saadurrehman007/Automated-Bit-Changing-Mechanism/README.md

# Automated-Bit-Changing-Mechanism
Design of an automatic on-the-go bit-changing mechanism for robotic screwdrivers
