saadurrehman007/Automated-Bit-Changing-Mechanism/ChainDriveAss.SLDASM

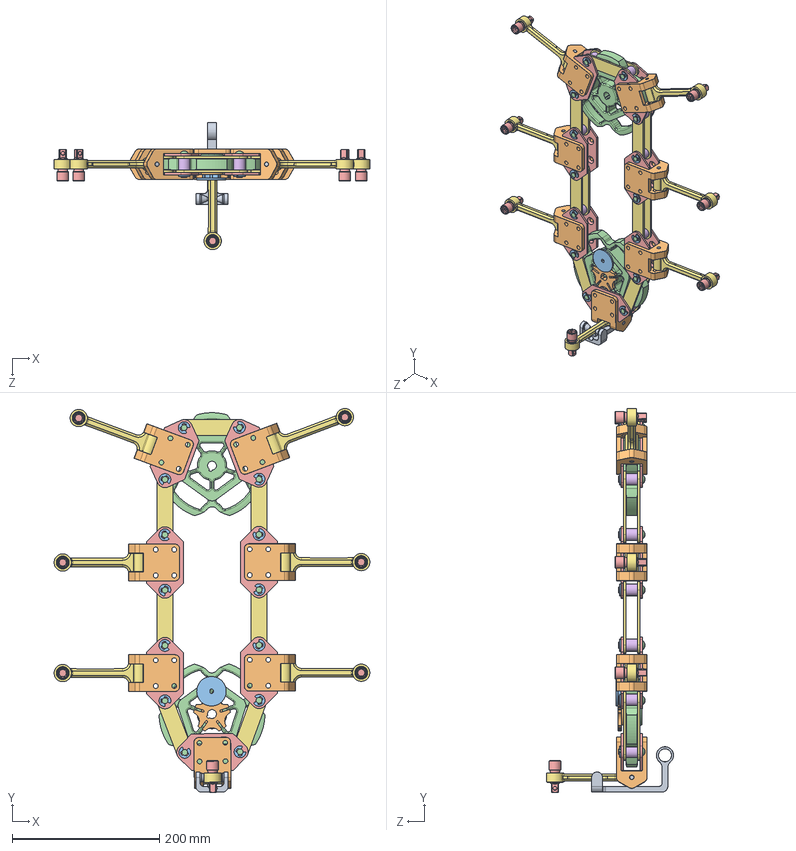
[picture p29: CAD file, 2024-09-28]
ChainDriveAss.SLDASM
428.2 x 520.8 x 172.5 mm
Link x 14
Roller x 14
AttachmentLink x 14
Pin x 14
EStyleRetainingRing x 14
Attachment x 7
DowelPin x 7
Bushing x 7
ToolArm x 7
NeedleRollerBearings x 7
SquareSocketExtension0.375 x 7
Sprocket1 x 2
GenevaDriveWheel
GenevaWheel
SwingArm
