saadurrehman007/Automated-Bit-Changing-Mechanism/ChainDriveAssemblyTree.SLDASM

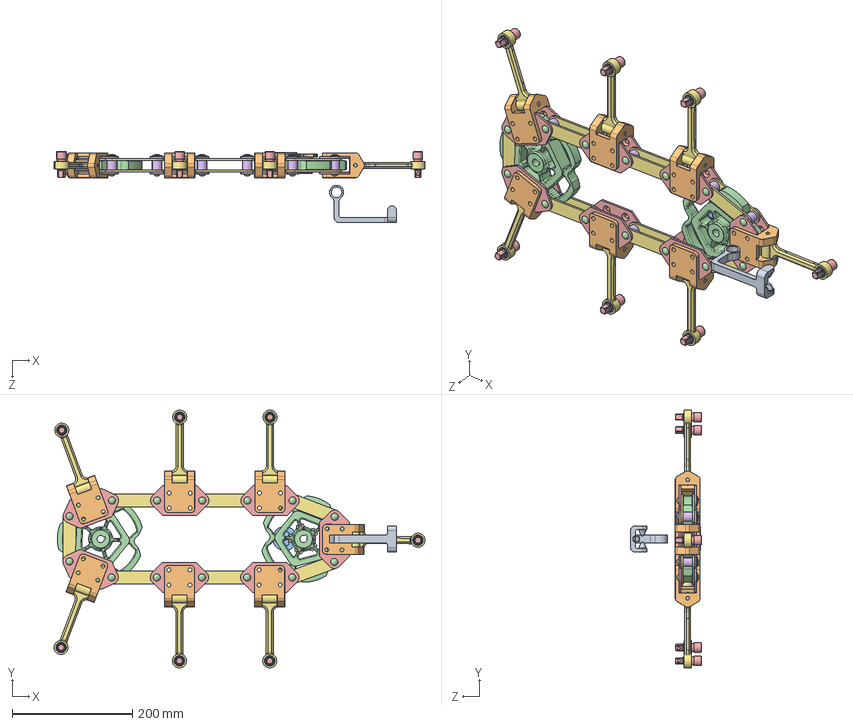
[picture p30: CAD file, 2024-09-28]
ChainDriveAssemblyTree.SLDASM
616.3 x 428.2 x 117.8 mm
Link x 14
Roller x 14
AttachmentLink x 14
Pin x 14
EStyleRetainingRing x 14
Attachment x 7
DowelPin x 7
Bushing x 7
ToolArm x 7
NeedleRollerBearings x 7
SquareSocketExtension0.375 x 7
Sprocket1 x 2
GenevaDriveWheel
GenevaWheel
SwingArm
