saadurrehman007/Automated-Bit-Changing-Mechanism/ChainGroup1.SLDASM

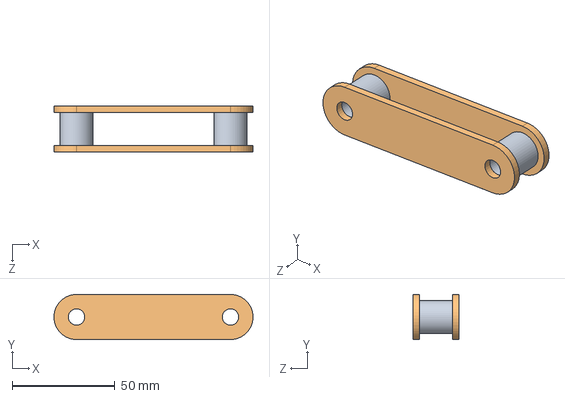
[picture p31: CAD file, 2024-09-28]
ChainGroup1.SLDASM
96.9 x 22.0 x 22.4 mm
Link x 2
Roller x 2
