saadurrehman007/Automated-Bit-Changing-Mechanism/MotionStudy.SLDASM

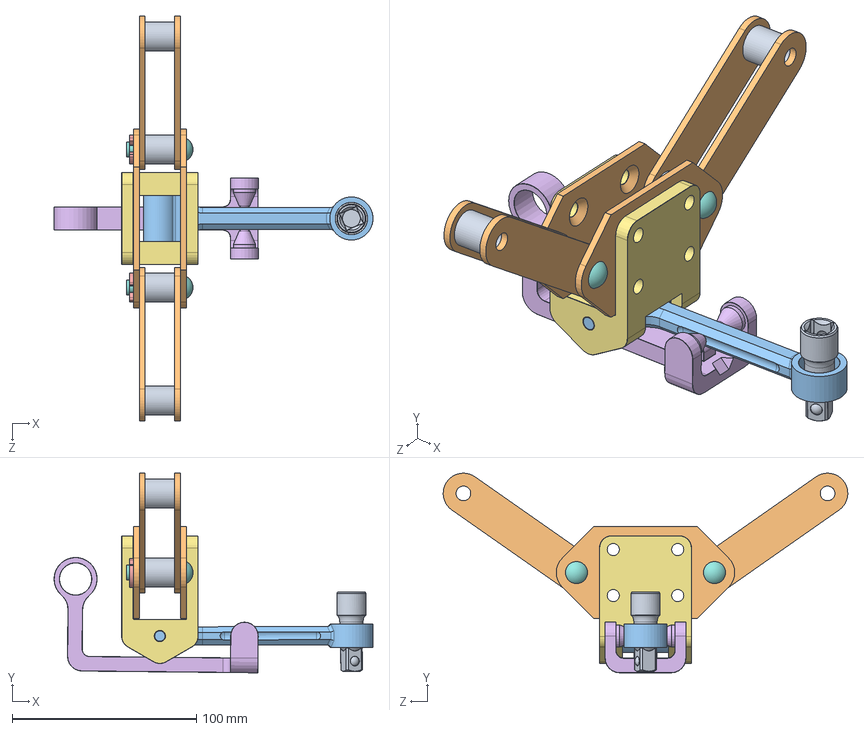
[picture p32: CAD file, 2024-09-28]
MotionStudy.SLDASM
173.3 x 108.5 x 219.8 mm
ToolArm
AttachmentLink x 2
SquareSocketExtension0.375
Pin x 2
Attachment
SwingArm
EStyleRetainingRing x 2
Bushing
DowelPin
Link x 4
Roller x 4
