saadurrehman007/Automated-Bit-Changing-Mechanism/SprocketsandGenevaMechanism.SLDASM

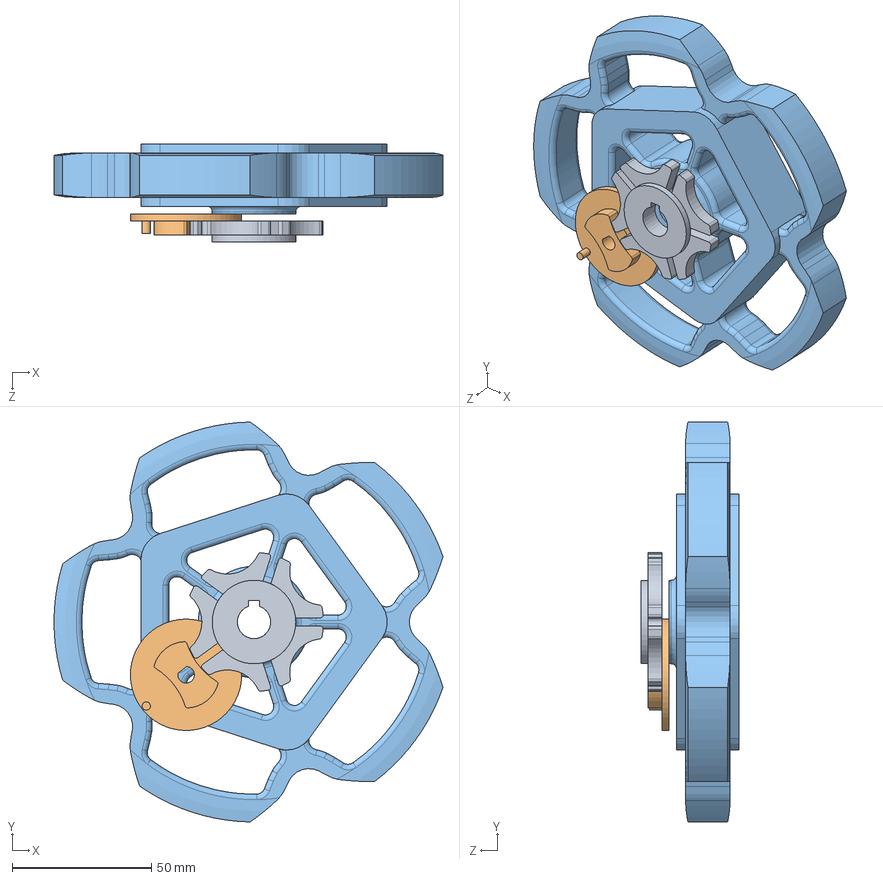
[picture p33: CAD file, 2024-09-28]
SprocketsandGenevaMechanism.SLDASM
139.7 x 143.6 x 35.2 mm
Sprocket1
GenevaDriveWheel
GenevaWheel
