saadurrehman007/Automated-Bit-Changing-Mechanism/ChainGroup2.SLDASM

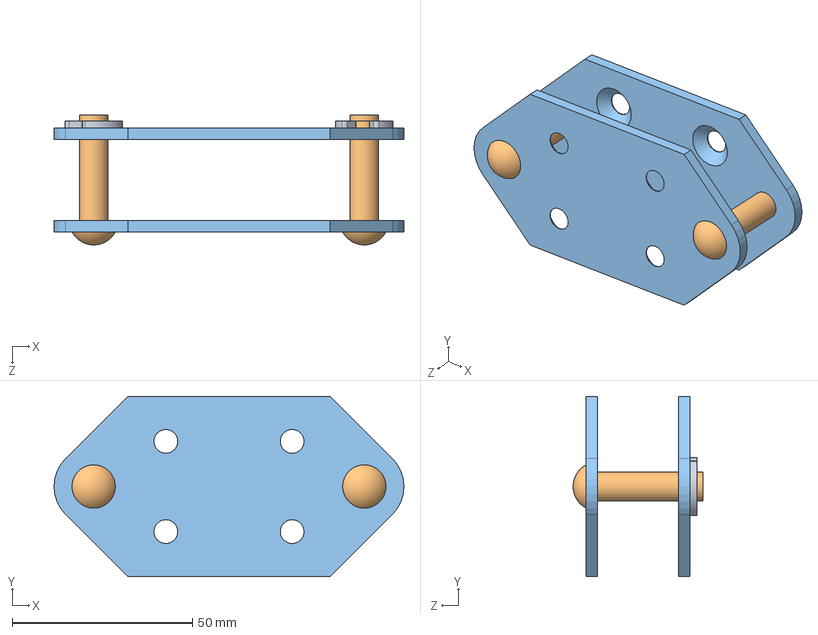
[picture p34: CAD file, 2024-09-28]
ChainGroup2.SLDASM
97.0 x 50.0 x 36.0 mm
AttachmentLink x 2
Pin x 2
EStyleRetainingRing x 2
