saadurrehman007/Automated-Bit-Changing-Mechanism/GenevaWheelMechanism.SLDASM

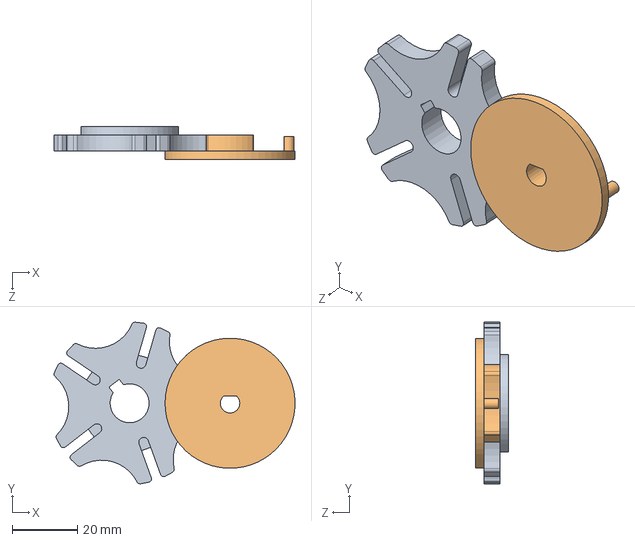
[picture p35: CAD file, 2024-09-28]
GenevaWheelMechanism.SLDASM
74.1 x 49.7 x 10.0 mm
GenevaDriveWheel
GenevaWheel
