saadurrehman007/Automated-Bit-Changing-Mechanism/AttachmentAssembly.SLDASM

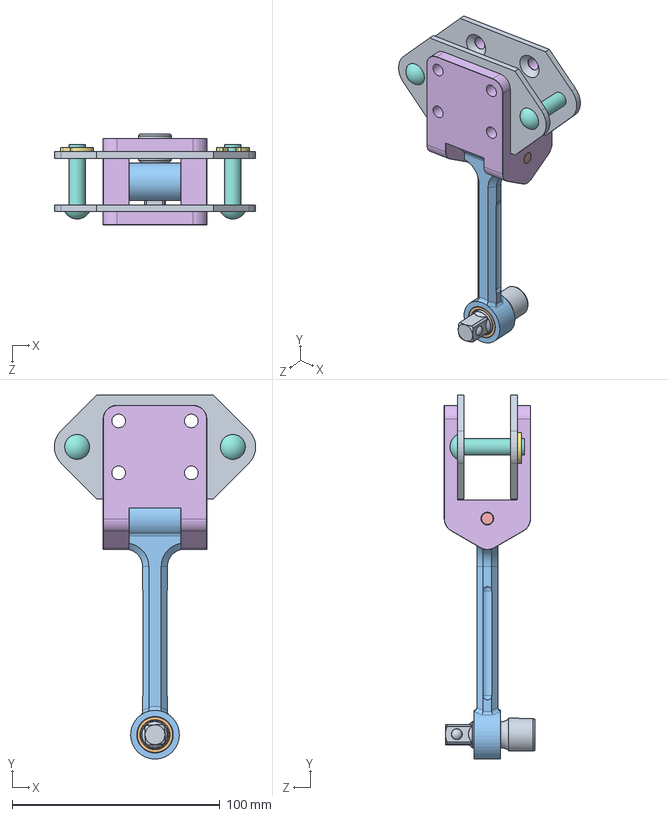
[picture p36: CAD file, 2024-09-28]
AttachmentAssembly.SLDASM
97.0 x 175.3 x 43.6 mm
AttachmentLink x 2
Pin x 2
EStyleRetainingRing x 2
Attachment
DowelPin
Bushing
ToolArm
NeedleRollerBearings
SquareSocketExtension0.375
