saadurrehman007/Automated-Bit-Changing-Mechanism/SquarePlug.SLDPRT

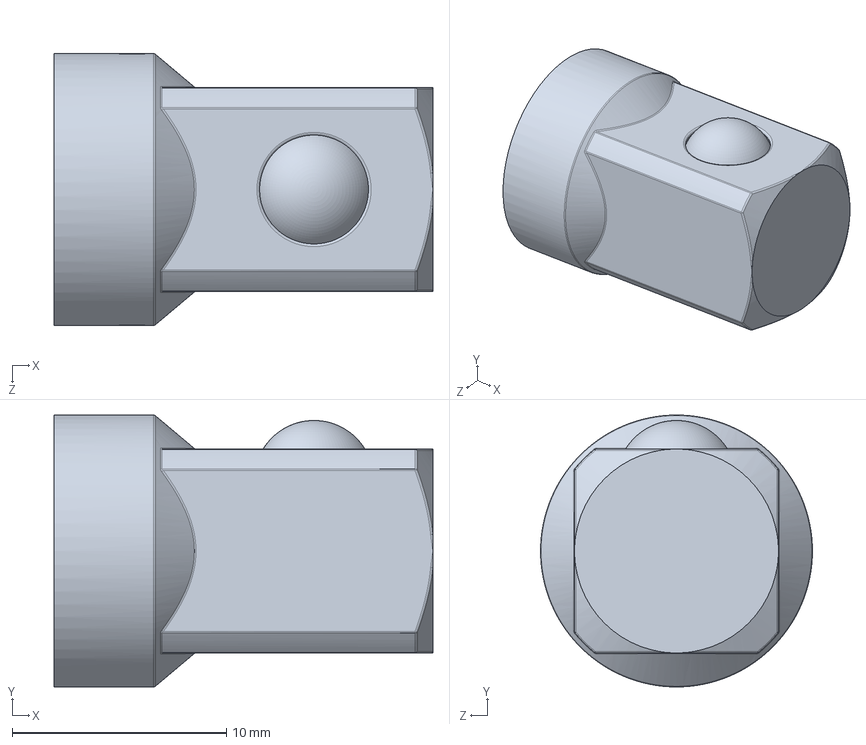
[picture p37: CAD file, 2024-09-28]
SquarePlug.SLDPRT
17.7 x 12.7 x 12.7 mm
