saadurrehman007/Automated-Bit-Changing-Mechanism/SquareSocketExtension0.375.SLDPRT

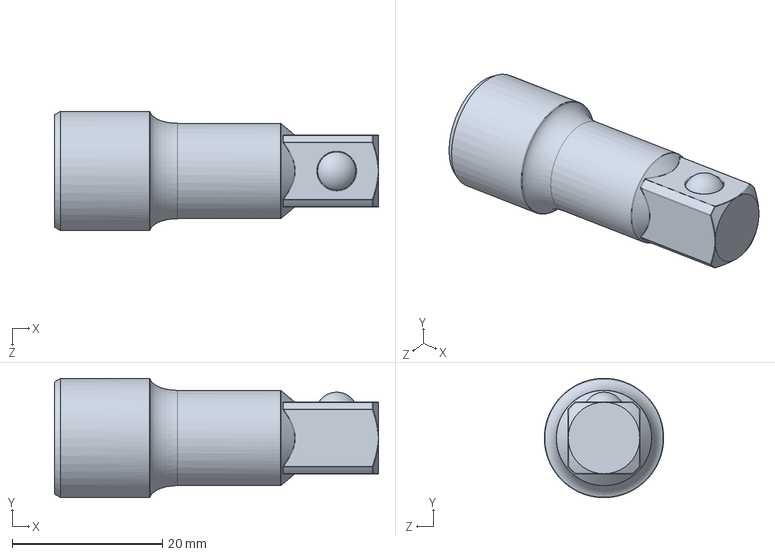
[picture p38: CAD file, 2024-09-28]
SquareSocketExtension0.375.SLDPRT
43.1 x 15.9 x 15.9 mm
