saadurrehman007/Automated-Bit-Changing-Mechanism/AttachmentLink.SLDPRT

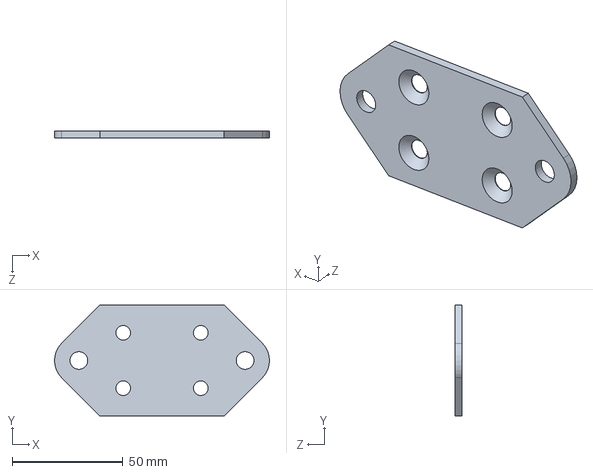
[picture p39: CAD file, 2024-09-28]
AttachmentLink.SLDPRT
97.0 x 50.0 x 3.20 mm
