saadurrehman007/Automated-Bit-Changing-Mechanism/Roller.SLDPRT

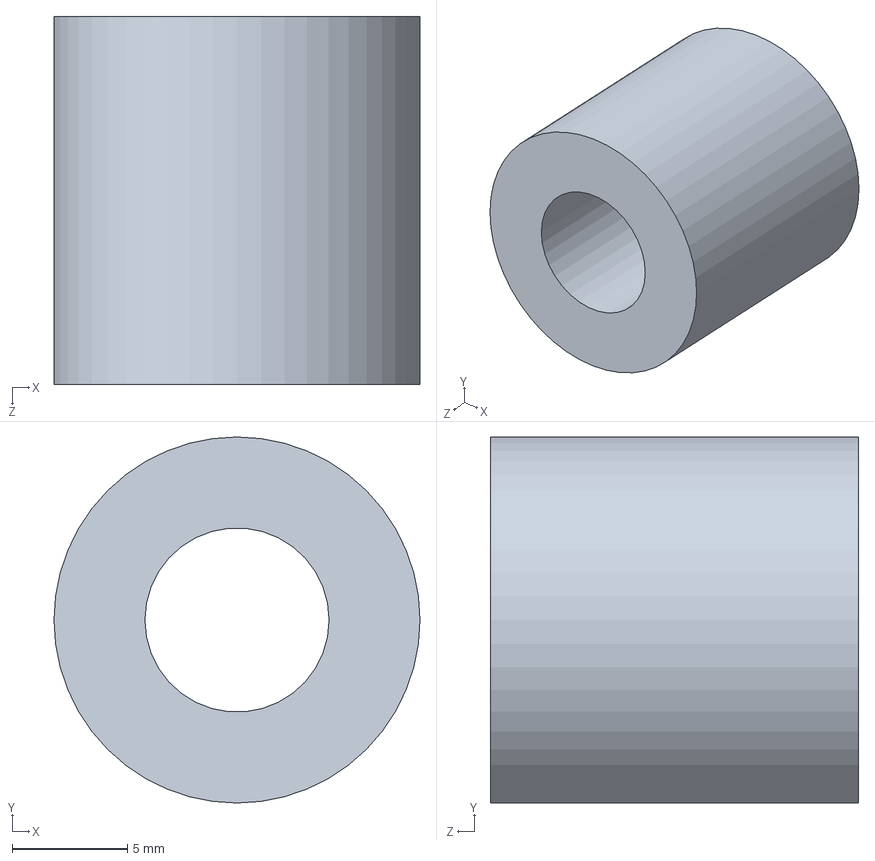
[picture p40: CAD file, 2024-09-28]
Roller.SLDPRT
15.9 x 15.9 x 16.0 mm
