saadurrehman007/Automated-Bit-Changing-Mechanism/DowelPin.SLDPRT

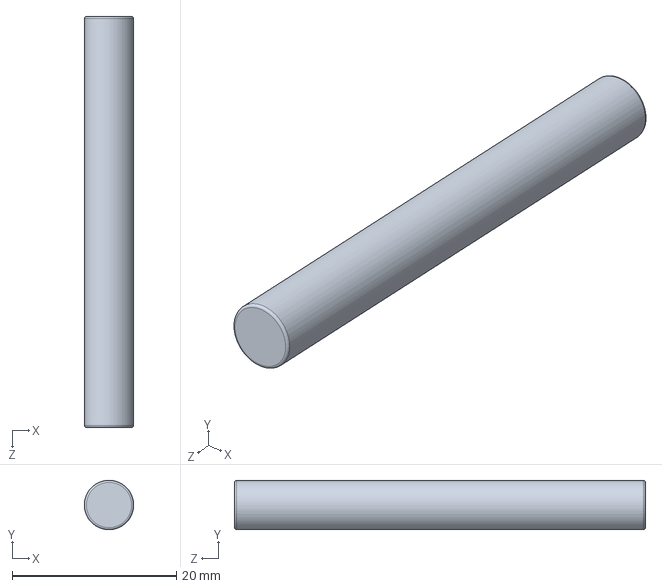
[picture p41: CAD file, 2024-09-28]
DowelPin.SLDPRT
6.00 x 6.00 x 50.0 mm
