saadurrehman007/Automated-Bit-Changing-Mechanism/Sprocket1.SLDPRT

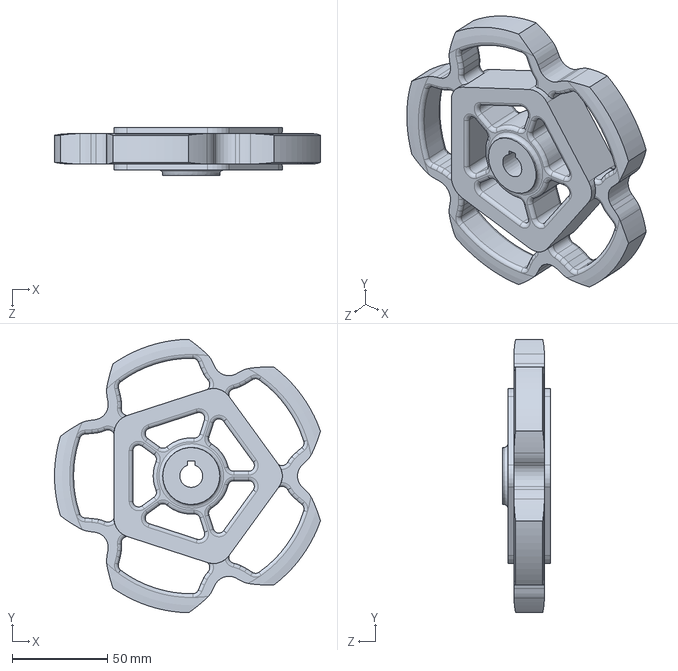
[picture p42: CAD file, 2024-09-28]
Sprocket1.SLDPRT
139.7 x 143.6 x 25.2 mm
