saadurrehman007/Automated-Bit-Changing-Mechanism/NeedleRollerBearings.SLDPRT

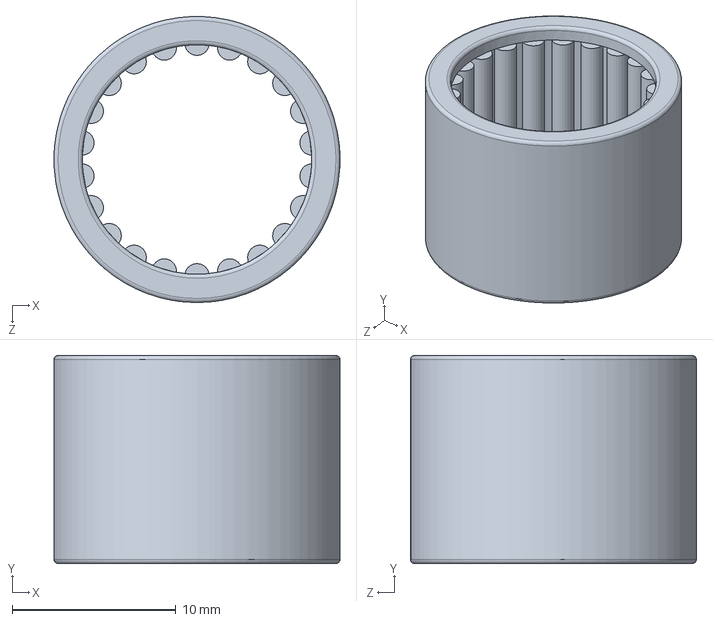
[picture p43: CAD file, 2024-09-28]
NeedleRollerBearings.SLDPRT
17.5 x 12.7 x 17.5 mm
