saadurrehman007/Automated-Bit-Changing-Mechanism/ToolArm.SLDPRT

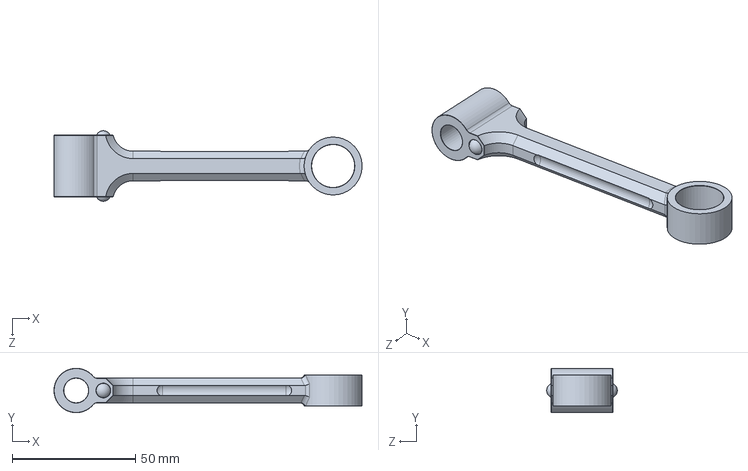
[picture p44: CAD file, 2024-09-28]
ToolArm.SLDPRT
124.8 x 18.0 x 28.6 mm
