saadurrehman007/Automated-Bit-Changing-Mechanism/Pin.SLDPRT

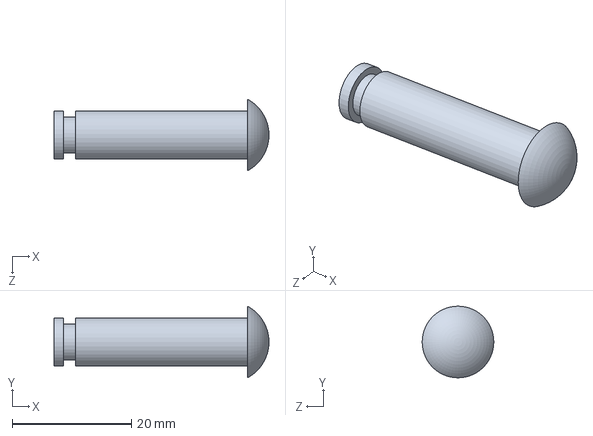
[picture p45: CAD file, 2024-09-28]
Pin.SLDPRT
36.0 x 12.0 x 12.0 mm
