saadurrehman007/Automated-Bit-Changing-Mechanism/Link.SLDPRT

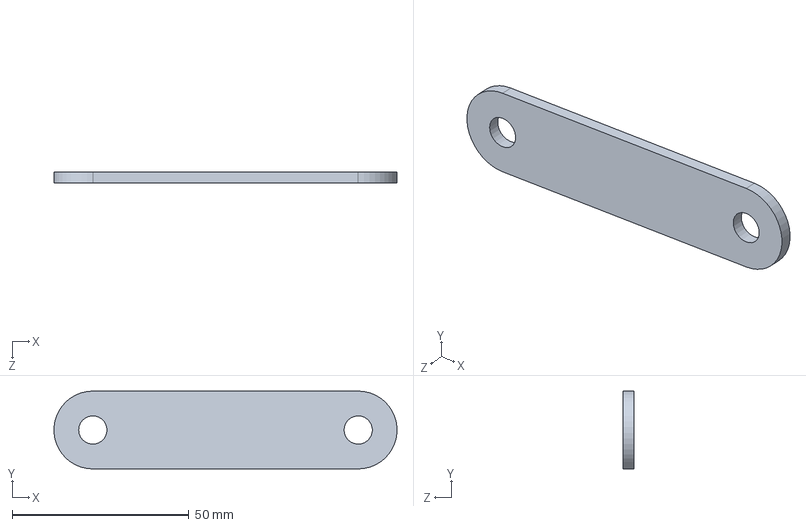
[picture p46: CAD file, 2024-09-28]
Link.SLDPRT
96.9 x 22.0 x 3.20 mm
