saadurrehman007/Automated-Bit-Changing-Mechanism/Bushing.SLDPRT

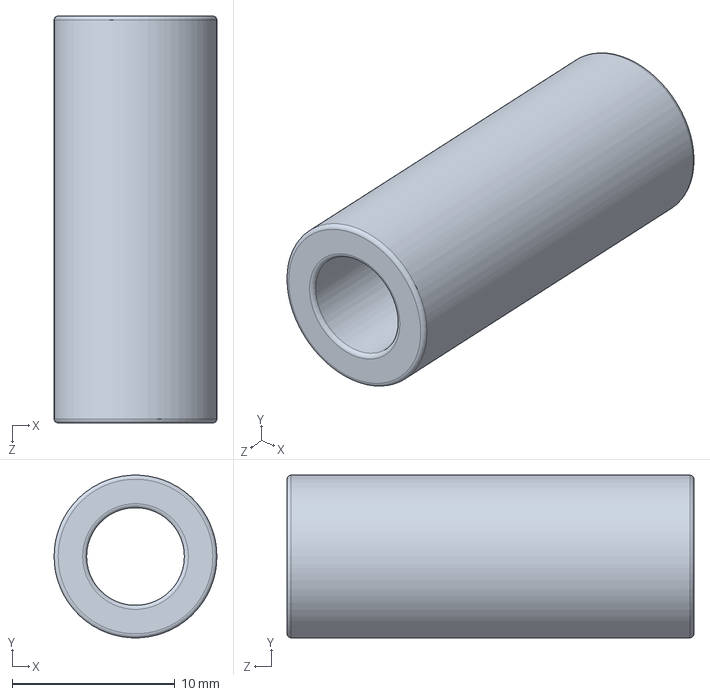
[picture p47: CAD file, 2024-09-28]
Bushing.SLDPRT
10.0 x 10.0 x 25.0 mm
