saadurrehman007/Automated-Bit-Changing-Mechanism/SwingArm.SLDPRT

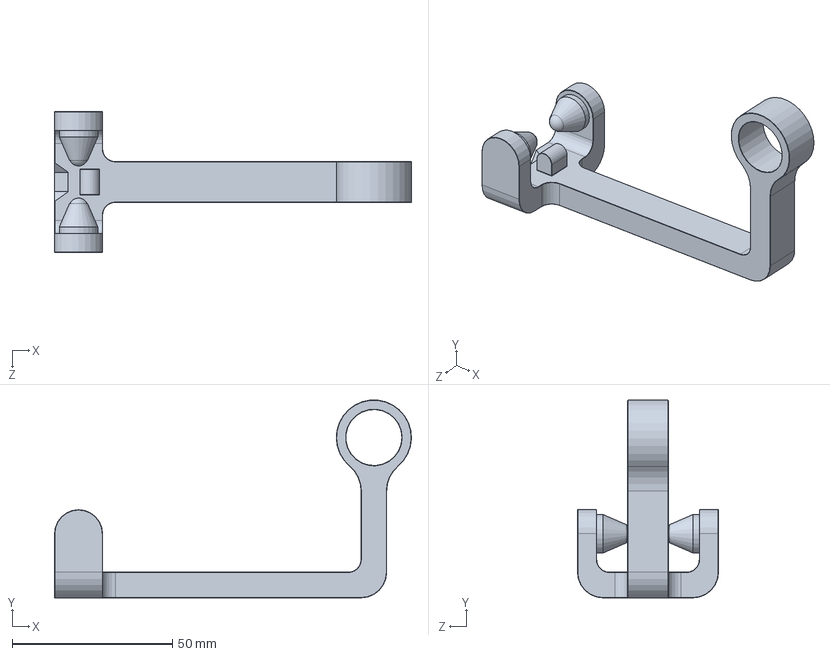
[picture p48: CAD file, 2024-09-28]
SwingArm.SLDPRT
111.3 x 61.7 x 44.0 mm
