saadurrehman007/Automated-Bit-Changing-Mechanism/EStyleRetainingRing.SLDPRT

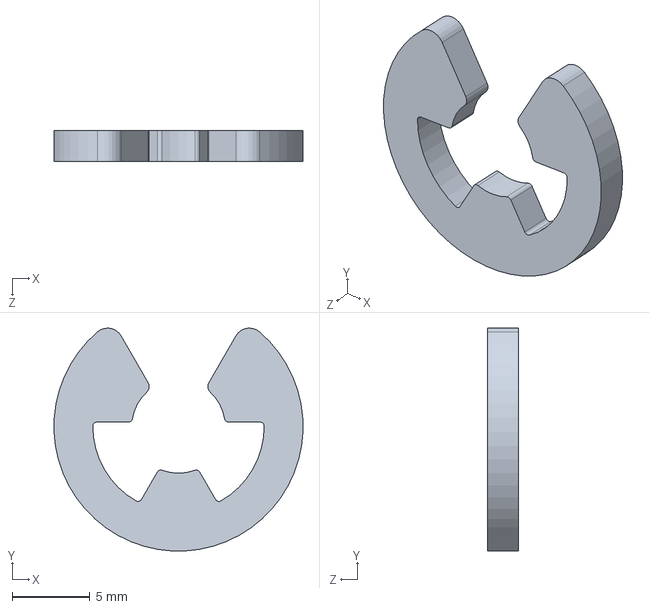
[picture p49: CAD file, 2024-09-28]
EStyleRetainingRing.SLDPRT
16.0 x 14.3 x 2.00 mm
