saadurrehman007/Automated-Bit-Changing-Mechanism/Attachment.SLDPRT

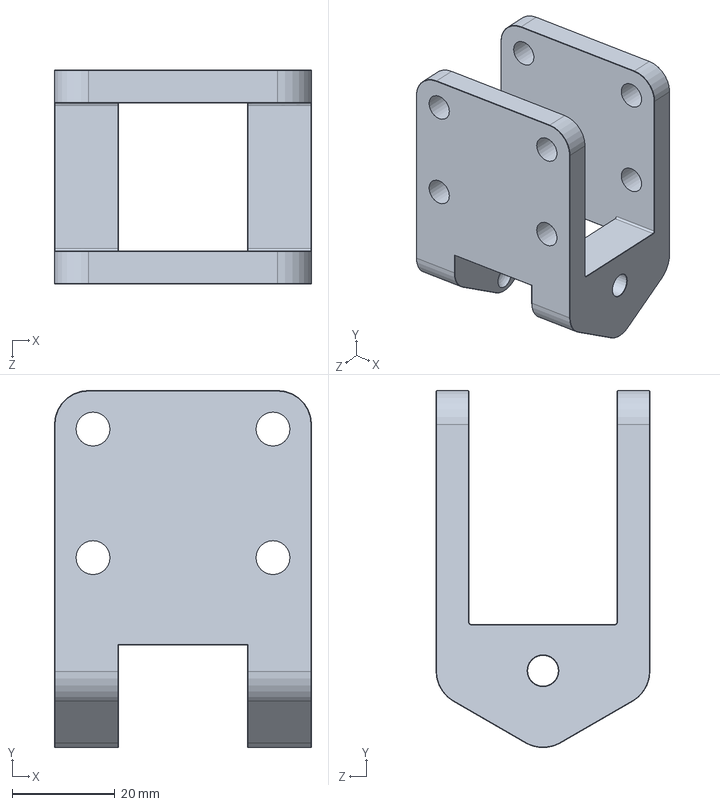
[picture p50: CAD file, 2024-09-28]
Attachment.SLDPRT
50.0 x 69.4 x 41.6 mm
