saadurrehman007/Automated-Bit-Changing-Mechanism/GenevaWheel.SLDPRT

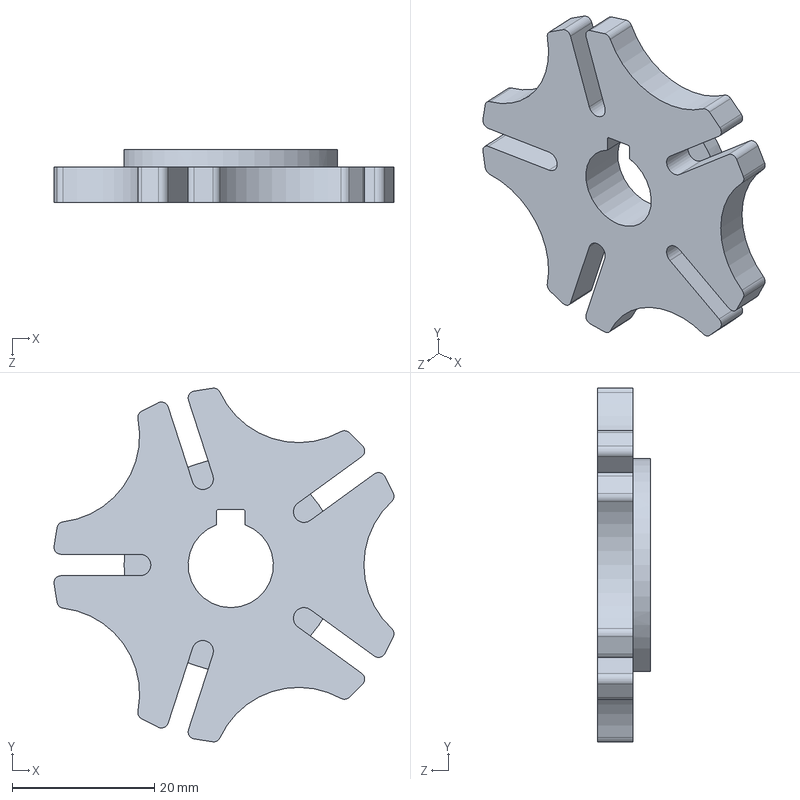
[picture p51: CAD file, 2024-09-28]
GenevaWheel.SLDPRT
47.8 x 49.7 x 7.50 mm
