saadurrehman007/Automated-Bit-Changing-Mechanism/GenevaDriveWheel.SLDPRT

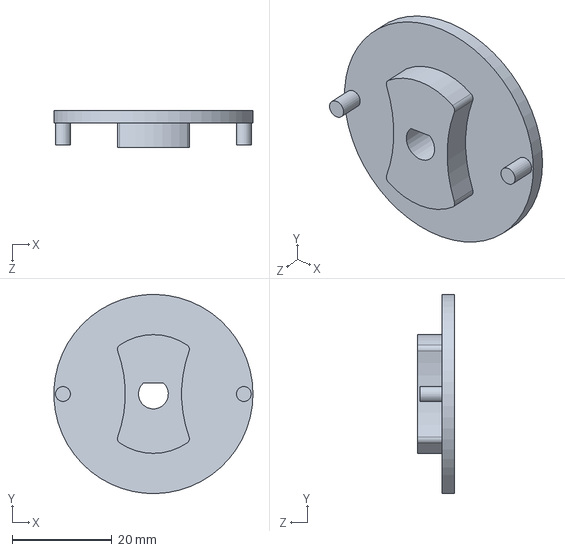
[picture p52: CAD file, 2024-09-28]
GenevaDriveWheel.SLDPRT
40.0 x 40.0 x 7.50 mm
