saadurrehman007/Automated-Bit-Changing-Mechanism/(list of files, cad)

Other CAD files:
ChainPath.SLDPRT
M6MachineScrew10mm.SLDPRT
Screwdriver.SLDPRT
